rolzwy7/SMiW-Projekt/Schemat ideowy/new/Bartosz.Nowakowski.pdf

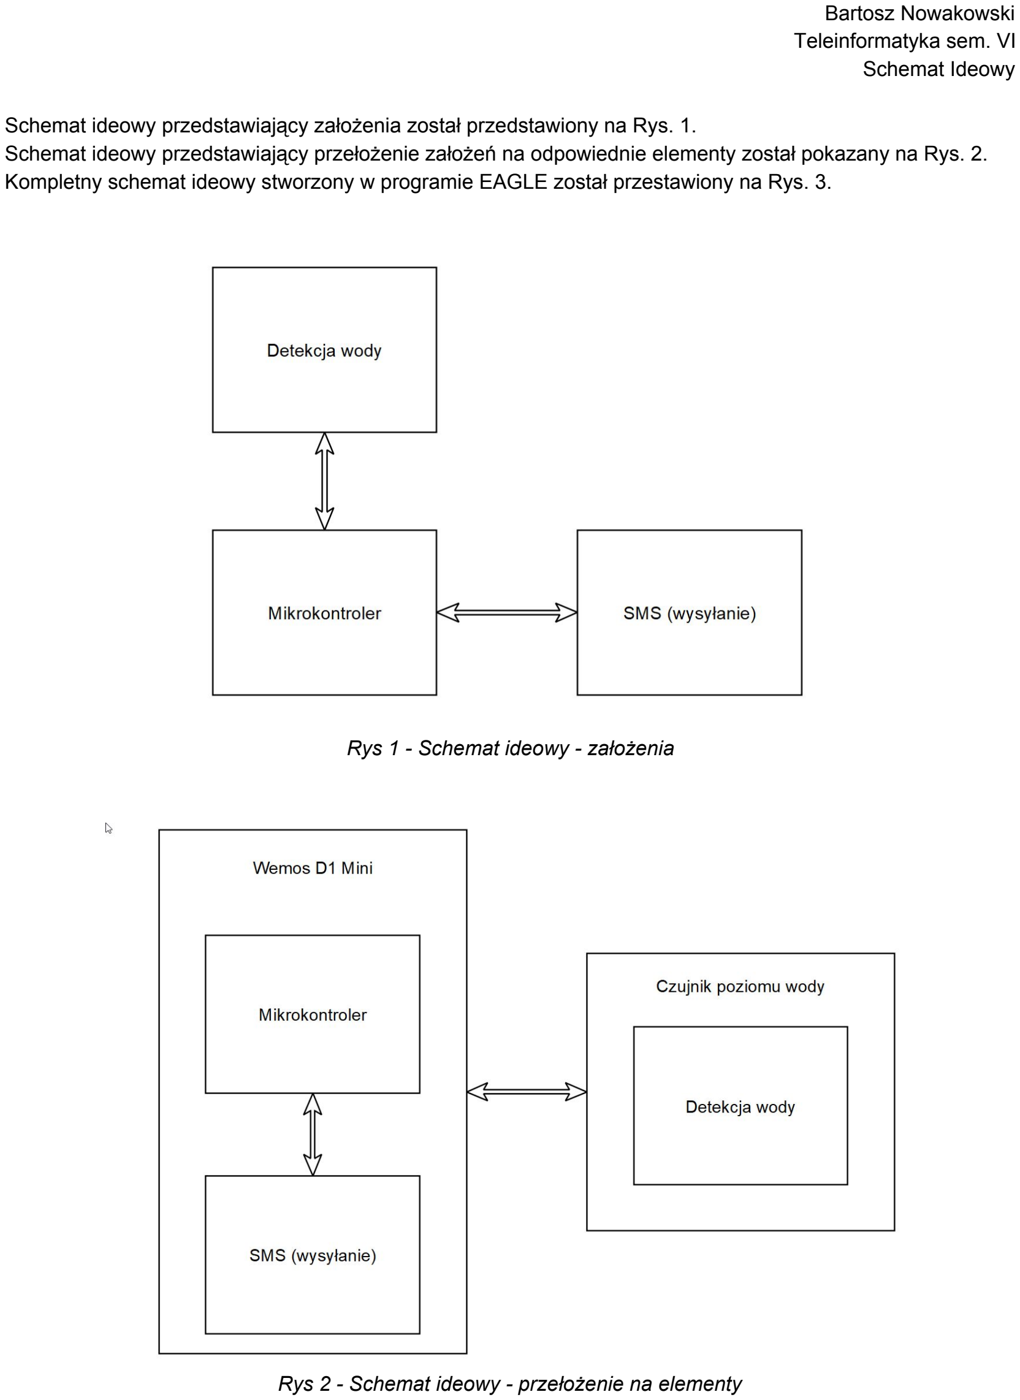
[picture p6: page 1]

Bartosz Nowakowski
Teleinformatyka sem. VI
Schemat Ideowy

Schemat ideowy przedstawiający założenia został przedstawiony na Rys. 1.
Schemat ideowy przedstawiający przełożenie założeń na odpowiednie elementy został pokazany na Rys. 2. Kompletny schemat ideowy stworzony w programie EAGLE został przestawiony na Rys. 3.

Rys 1 - Schemat ideowy - założenia

Rys 2 - Schemat ideowy - przełożenie na elementy

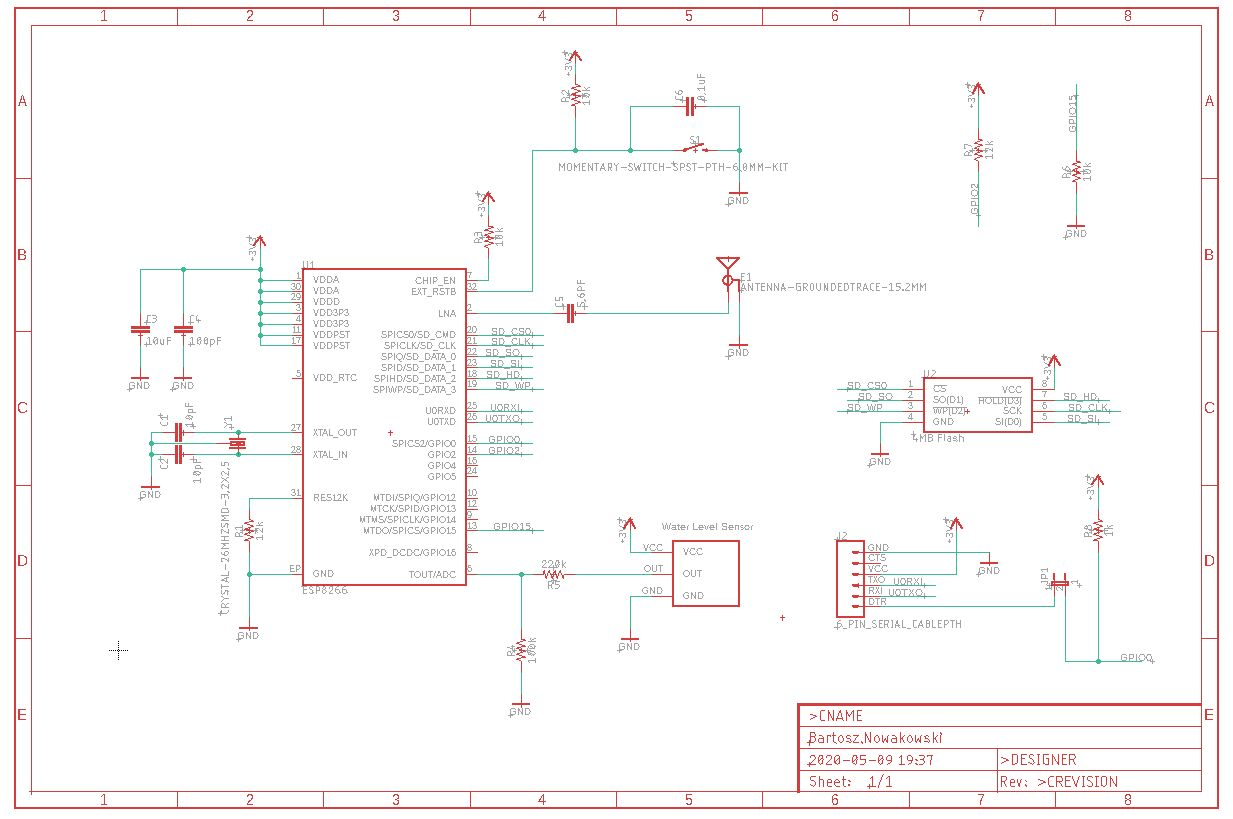
[picture p7: figure]

Rys 3 - Kompletny schemat ideowy
