rolzwy7/SMiW-Projekt/Schemat ideowy/new/Bartosz.Nowakowski.all.bmp

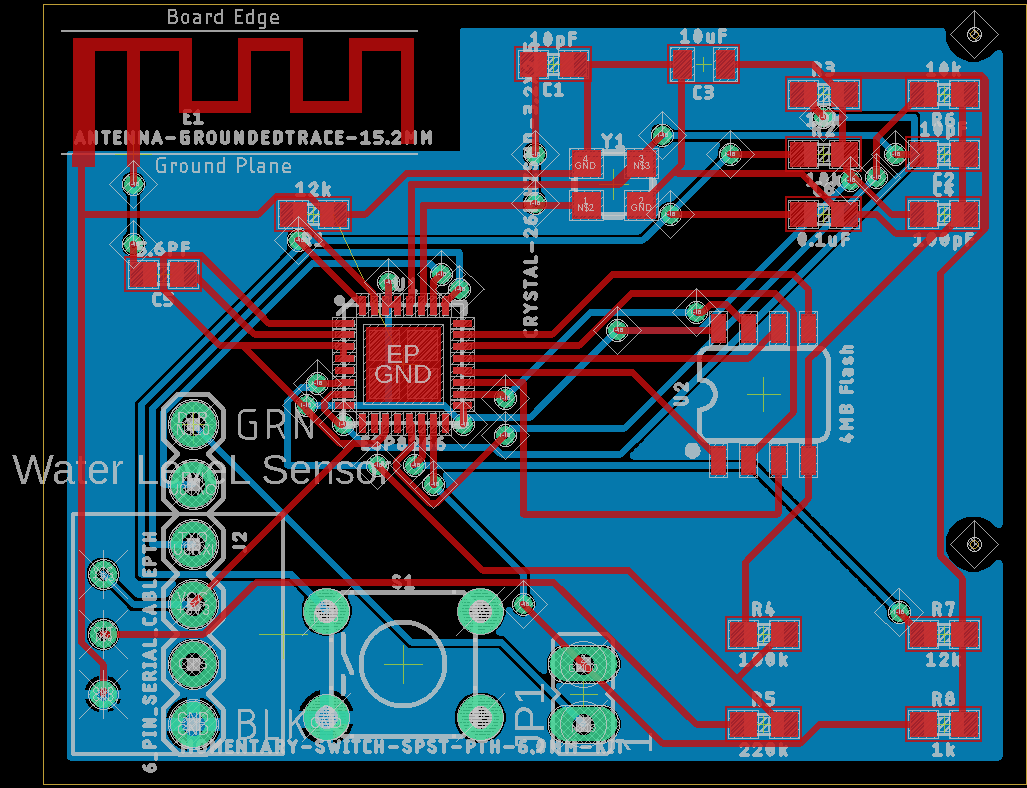
Schemat ideowy/new/Bartosz.Nowakowski.all.bmp
