rolzwy7/SMiW-Projekt/Schemat ideowy/new/Bartosz.Nowakowski.bot.bmp

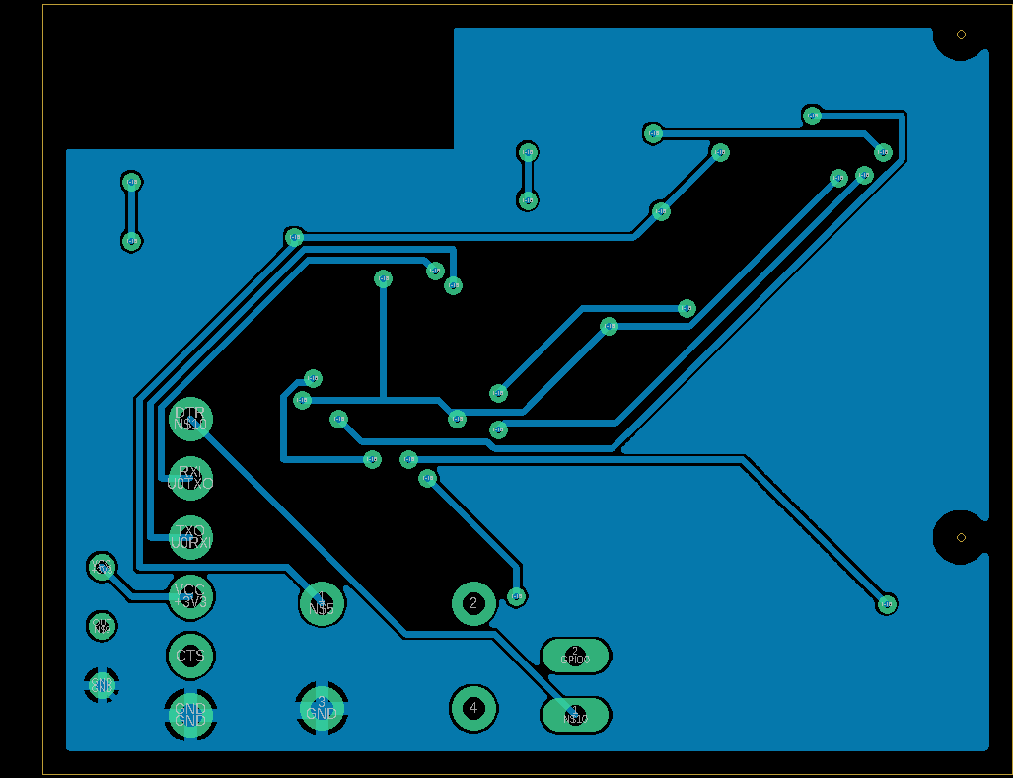
Schemat ideowy/new/Bartosz.Nowakowski.bot.bmp
