rolzwy7/SMiW-Projekt/Schemat ideowy/new/Bartosz.Nowakowski.top.bmp

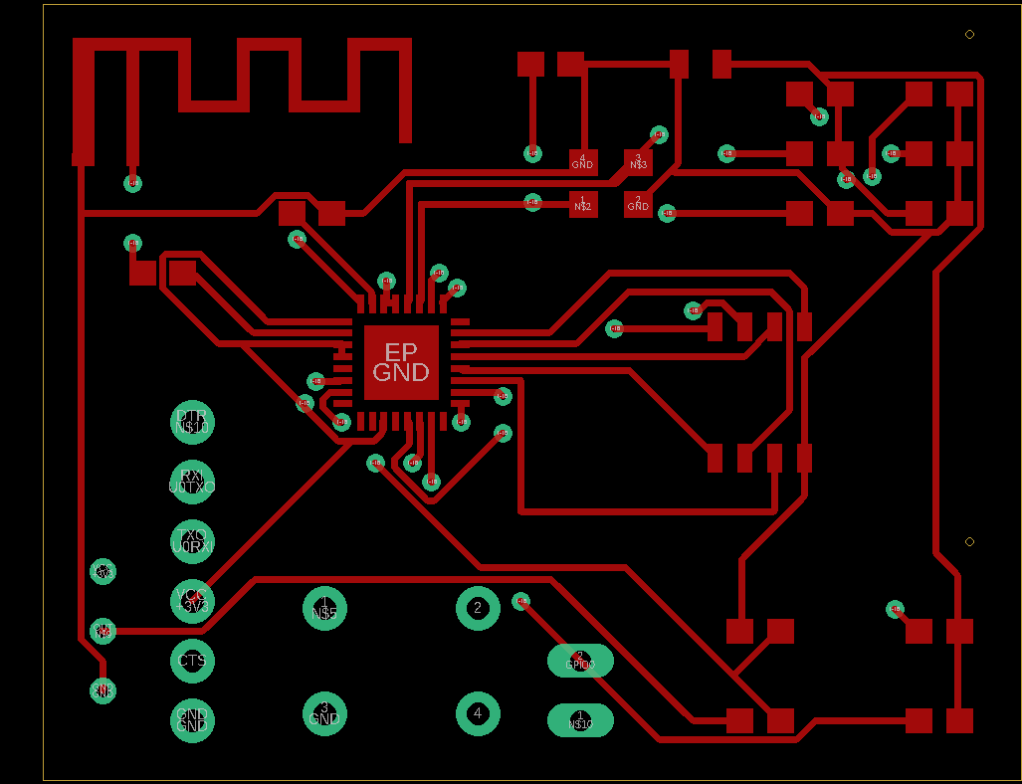
Schemat ideowy/new/Bartosz.Nowakowski.top.bmp
