rolzwy7/SMiW-Projekt/Schemat ideowy/p/Bartosz.Nowakowski.all.bmp

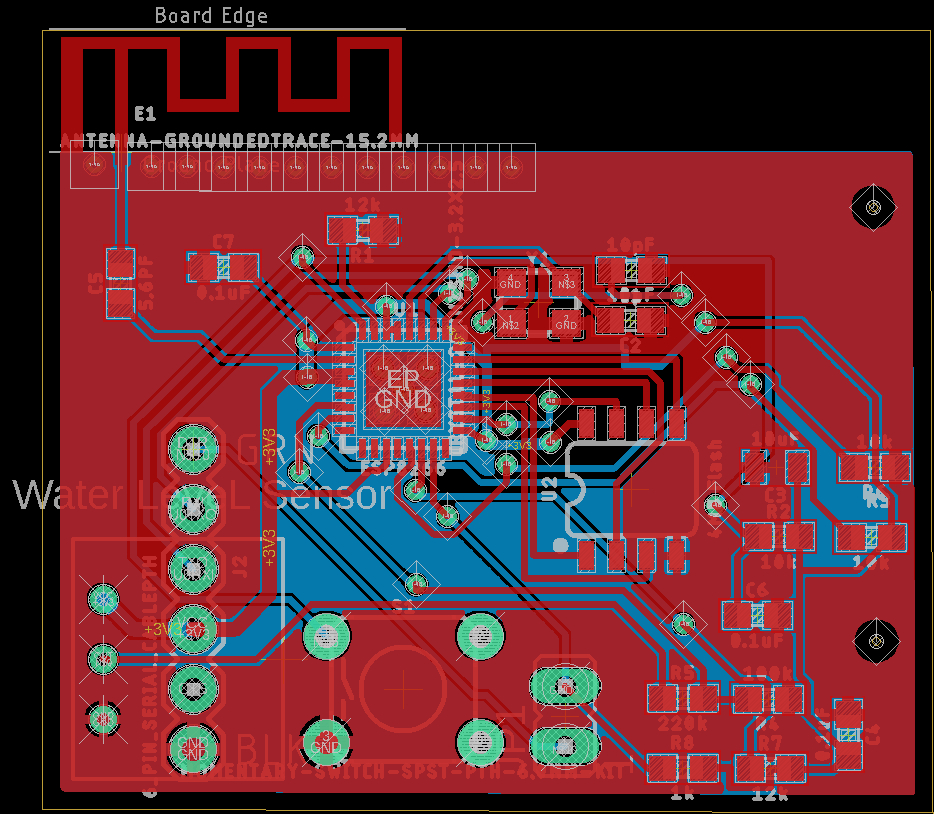
Schemat ideowy/p/Bartosz.Nowakowski.all.bmp
