rolzwy7/SMiW-Projekt/Schemat ideowy/p/Bartosz.Nowakowski.bot.bmp

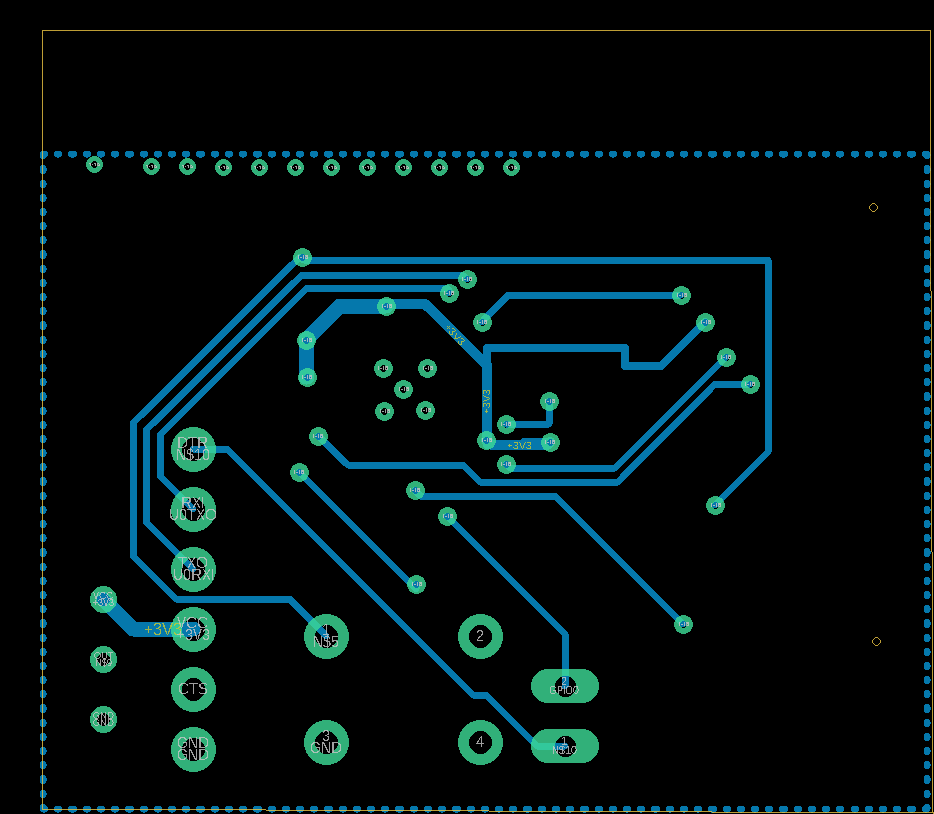
Schemat ideowy/p/Bartosz.Nowakowski.bot.bmp
