rolzwy7/SMiW-Projekt/Schemat ideowy/p/Bartosz.Nowakowski.top.bmp

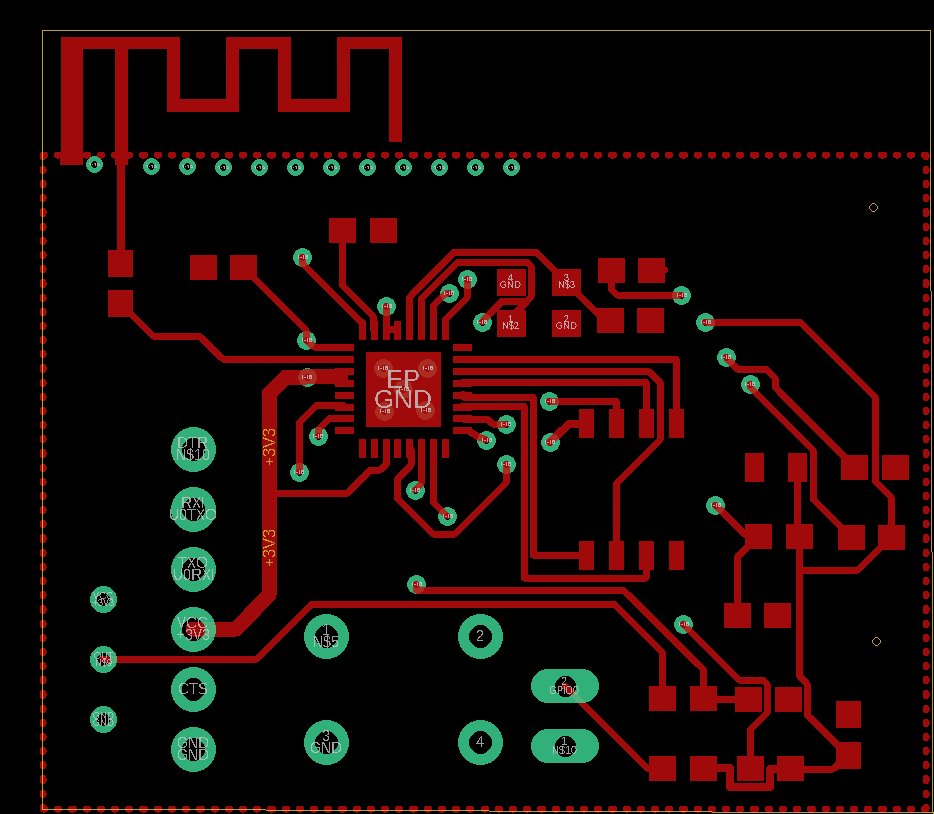
Schemat ideowy/p/Bartosz.Nowakowski.top.bmp
