rolzwy7/SMiW-Projekt/(list of files, drawings)

Other design files:
Schemat ideowy/new/Bartosz.Nowakowski.fzz
