rolzwy7/SMiW-Projekt/Schemat ideowy/new/Bartosz.Nowakowski.brd

## EAGLE design Schemat ideowy/new/Bartosz.Nowakowski.brd (2020-05-10)

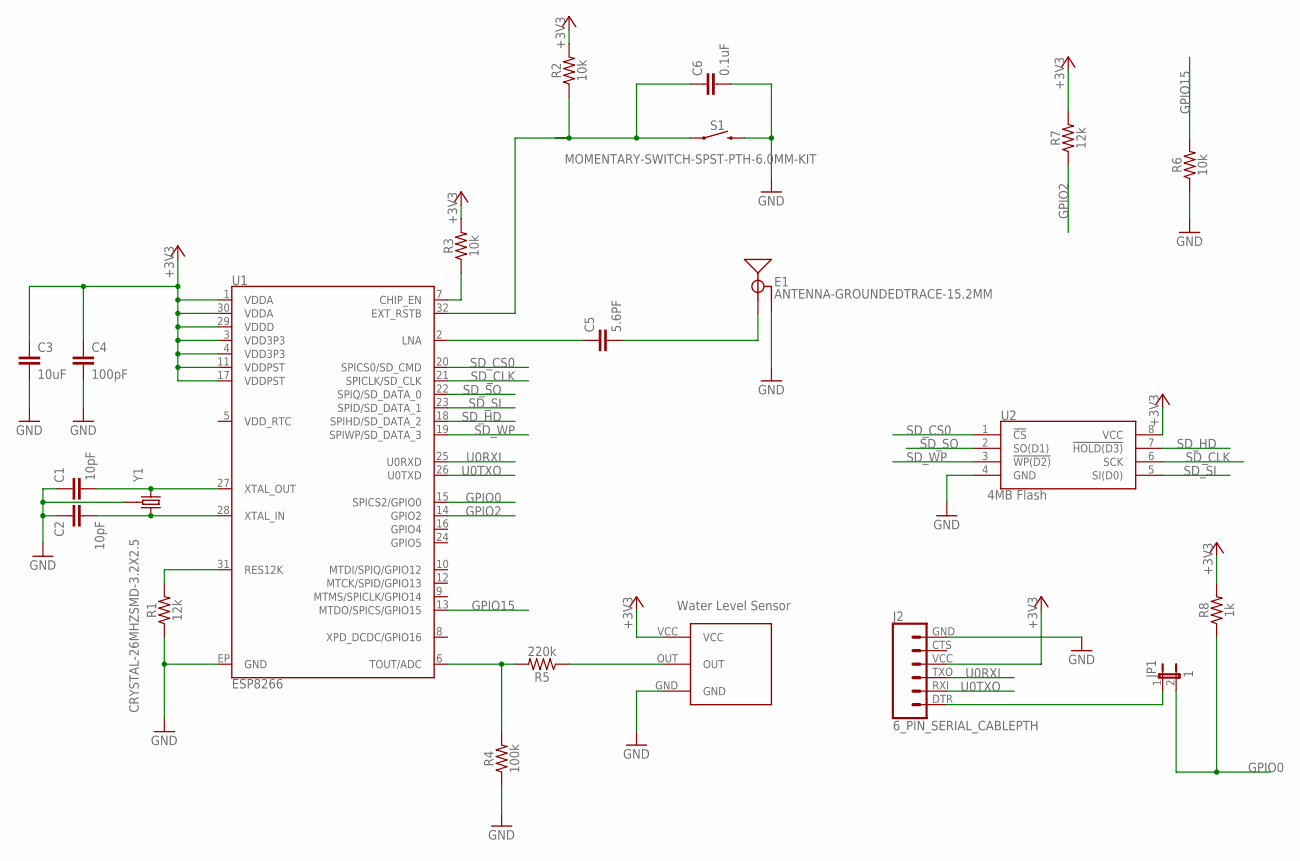
[picture p14: schematic Bartosz.Nowakowski.sch]

Parts:
C1, C2: 10pF; 0603
C3: 10uF; 0805
C4: 100pF; 0603
C5: 5.6PF; 0603
C6: 0.1uF; 0603
E1: ANTENNA-GROUNDEDTRACE-15.2MM; TRACE_ANTENNA_2.4GHZ_15.2MM
J2: 6_PIN_SERIAL_CABLEPTH; FTDI_BASIC
JP1: 1; JP1
R1, R7: 12k; 0603
R2, R3, R6: 10k; 0603
R4: 100k; 0603
R5: 220k; 0603
R8: 1k; 0603
S1: MOMENTARY-SWITCH-SPST-PTH-6.0MM-KIT; TACTILE_SWITCH_PTH_6.0MM_KIT
U1: ESP8266; QFN32-5X5MM
U2: 4MB Flash; SO08
WATER1: WATERLEVELSENORDEV; WATERLEVELSENSORFT
Y1: CRYSTAL-26MHZSMD-3.2X2.5; CRYSTAL-SMD-3.2X2.5MM

Connections:
+3V3: C3.1, C4.1, J2.VCC (4), R2.2, R3.2, R7.2, R8.2, U1.1 (VDDA), U1.3 (VDD3P3), U1.4 (VDD3P3), U1.11 (VDDPST), U1.17 (VDDPST), U1.29 (VDDD), U1.30 (VDDA), U2.8 (VCC), WATER1.VCC
GND: C1.1, C2.1, C3.2, C4.2, C6.2, E1.GND, J2.GND (6), R1.1, R4.1, R6.1, S1.3 (2), U1.EP (GND), U2.4 (GND), WATER1.GND, Y1.2 (3), Y1.4 (3)
GPIO0: JP1.2, R8.1, U1.15 (SPICS2/GPIO0)
GPIO2: R7.1, U1.14 (GPIO2)
GPIO15: R6.2, U1.13 (MTDO/SPICS/GPIO15)
unnamed: R1.2, U1.31 (RES12K)
unnamed: C1.2, U1.27 (XTAL_OUT), Y1.1
unnamed: C2.2, U1.28 (XTAL_IN), Y1.3 (2)
unnamed: R3.1, U1.7 (CHIP_EN)
unnamed: C6.1, R2.1, S1.1, U1.32 (EXT_RSTB)
unnamed: C5.1, U1.2 (LNA)
unnamed: C5.2, E1.ANT (SIGNAL)
unnamed: R4.2, R5.2, U1.6 (TOUT/ADC)
unnamed: R5.1, WATER1.OUT
unnamed: J2.DTR (1), JP1.1
SD_CLK: U1.21 (SPICLK/SD_CLK), U2.6 (SCK)
SD_CS0: U1.20 (SPICS0/SD_CMD), U2.1 (!CS)
SD_HD: U1.18 (SPIHD/SD_DATA_2), U2.7 (!HOLD(D3))
SD_SI: U1.23 (SPID/SD_DATA_1), U2.5 (SI(D0))
SD_SO: U1.22 (SPIQ/SD_DATA_0), U2.2 (SO(D1))
SD_WP: U1.19 (SPIWP/SD_DATA_3), U2.3 (!WP(D2))
U0RXI: J2.TXO (3), U1.25 (U0RXD)
U0TXO: J2.RXI (2), U1.26 (U0TXD)

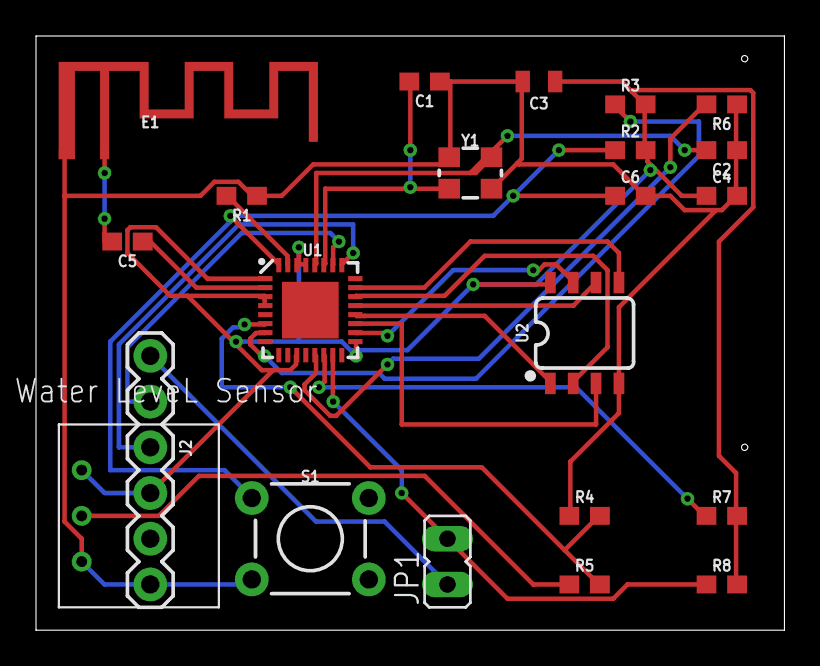
[picture p15: board Bartosz.Nowakowski.brd from above]

Board: 2 copper layers, 41.6 x 33.0 mm, 22 parts (0 on the bottom side), 23 nets.
